AutoNexTeam/AUTONEX_BOT_2025/Team_Photo/Team Autonex.png

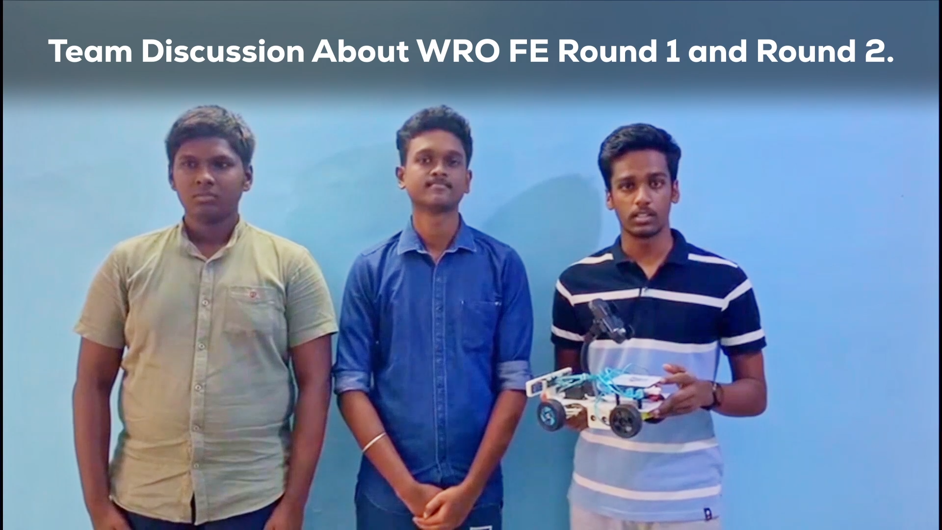
Team_Photo/Team Autonex.png
