AutoNexTeam/AUTONEX_BOT_2025/Bot Firmware/WRO_Round_1_Code_Final/WRO_Round_1_Code_Final.ino

// ########### Loop ############################################################################################################ //
int line_chk_count = 12;  // 3 Laps - 12 count, 1 Lap - 4 count.
int line_count = 0; // 12
//#---Bot Speeds---######################################################################
int normal_speed = 200;//pwm
int turn_speed = 220;//pwm
int turn_delay = 2000;//ms
//#######################################################################################
int fus_slow_speed = 200;//pwm
int fus_slow_dist = 130;//cm
//#---Servo Angles---####################################################################
int servo_center = 100;//deg
int left_turn_angle = servo_center - 20; //80 deg
int right_turn_angle = servo_center + 20;//120 deg
//####################################################################
const int blue_line_thold = 8000; //Blue Color Temp value
const int orange_line_thold = 3000; //Orange Color Temp value
//####################################################################
bool COLOR_LOCK = 1;
bool lt_st_count = 0;
bool rt_st_count = 0;

bool left_right_arc_turn = 1;
bool left_right_r_turn = 0;
//#########################################################################################//
#define DPDT_Push_Button_Pin 34

int col_val, start_col, colour_line;  // colour_line = 1 ->> Orange // colour_line = 3 ->> Blue
int f_us, f1_us, f2_us, b_us, l_us, r_us, fusa, far;

bool LOGIC_LOCK = 1; //1 True state.
bool DPDT_STATE = 0; //0 False state.
//#########################################################################################//

void loop() {
  
  DPDT_STATE = digitalRead(DPDT_Push_Button_Pin);
  //Serial.println("DPDT Button State : "+String(DPDT_STATE));

  US_Values(f_us, f1_us, f2_us, b_us, l_us, r_us);
  // Serial.println("F_US : " + String(f_us) + " | F1_US : " + String(f1_us) + " | F2_US : " + String(f2_us) + 
  //             " | B_US : " + String(b_us) + 
  //             " | L_US : " + String(l_us) + " | R_US : " + String(r_us));

  col_val = front_colour_sensor();
  //Serial.println("Color Value : " + String(col_val));

  color_line_fun(); // color line pickup

  
  if (DPDT_STATE == 1) 
  { 
    if (LOGIC_LOCK == 1) 
    { 
      if (col_val != 0)
      {
        color_logic_fun();
      }
      else if (col_val == 0)
      {
        side_us_logic_fun();
      }   
    }     
  }
  else
  {
    bot_shutdown();
  }

  if (line_count == line_chk_count) 
  {
    end_stop();
    bot_shutdown();
    LOGIC_LOCK = 0;
    line_count = 0; 
  }   

}


void color_line_fun()
{
  if(COLOR_LOCK == 1)
  {
    if(col_val == 1)
    {
      start_col = 1;
      colour_line = 1;
      COLOR_LOCK = 0;
    }
    else if(col_val == 3)
    {
      start_col = 3;
      colour_line = 3;
      COLOR_LOCK = 0;
    }
  }
}

void color_logic_fun()
{

   //# Orange Line & Right Turn Condition: #/////////////////////////////////////////////////////////////////
      if ((col_val == colour_line) && (col_val != 3))
      { 
        line_count++;
        Serial.println("Orange Line Count : " + String(line_count));

        if(left_right_arc_turn)
        {
          rgb_led(0, 0, 0);  
          delay(1);
          motor_forward(turn_speed);
          rgb_led(150, 0, 150);
          moveServoTo(right_turn_angle);
          delay(turn_delay);
          moveServoTo(servo_center);
          delay(1);
          rgb_led(0, 0, 0);
        }

        if(left_right_r_turn)
        {
          rgb_led(0, 0, 0);
          motor_forward(turn_speed);
          delay(1); 
          rgb_led(150, 0, 150);

          moveServoTo(right_turn_angle);
          delay(1500); 
          motor_backward(210);
          delay(1);      
          moveServoTo(left_turn_angle);
          delay(1500);
          moveServoTo(servo_center);
          delay(1);  
          motor_forward(200);
          delay(1); 
          rgb_led(0, 0, 0);
        }

      } 
      
      //# Blue Line & Left Turn Condition: #/////////////////////////////////////////////////////////////////
      if ((col_val == colour_line) && (col_val != 1))
      { 
        line_count++;
        Serial.println("Blue Line Count : " + String(line_count));

        if(left_right_arc_turn)
        {
          rgb_led(0, 0, 0);
          delay(1);
          motor_forward(turn_speed);
          rgb_led(150, 0, 150);
          moveServoTo(left_turn_angle);
          delay(turn_delay);
          moveServoTo(servo_center);
          rgb_led(0, 0, 0);
        }
        
        if(left_right_r_turn)
        {
          rgb_led(0, 0, 0);
          motor_forward(turn_speed);
          delay(1); 
          rgb_led(150, 0, 150);

          moveServoTo(left_turn_angle);
          delay(1500); 
          motor_backward(turn_speed);
          delay(1);      
          moveServoTo(right_turn_angle);
          delay(1500);
          moveServoTo(servo_center);
          delay(1);  
          motor_forward(200);
          delay(1); 
          rgb_led(0, 0, 0);
        }
        

        
      } 

}

void side_us_logic_fun()
{              
    if(f_us < fus_slow_dist){motor_forward(fus_slow_speed);}
    else{motor_forward(normal_speed);}

    if ((l_us < 30) && (l_us != 0))
    { 
        rgb_led(0, 0, 0);
        rgb_led(255, 0, 50); 
        moveServoTo(servo_center + 10);

        if(rt_st_count == 0)
        {
          if(lt_st_count == 0)
          {
            lt_st_count = 1;
          }
        }

    }
    if ((l_us > 30) && (r_us > 30) && (l_us != 0) && (r_us != 0)) 
    { 
        rgb_led(0, 0, 0);
        rgb_led(255, 255, 0);
        moveServoTo(servo_center); //100
    } 

    if ((r_us < 30) && (r_us != 0))
    {
        rgb_led(0, 0, 0);
        rgb_led(255, 0, 50); 
        moveServoTo(servo_center - 10);//90

        if(lt_st_count == 0)
        {
          if(rt_st_count == 0)
          {
            rt_st_count = 1;
          }
        }

    }
}

void bot_shutdown()
{
  motor_stop();
  moveServoTo(servo_center);
  rgb_led(0, 0, 0);
}

void left_stop()
{
  rgb_led(0, 0, 0);
  delay(1);
  rgb_led(255, 255, 255);
  
  if(left_right_arc_turn)
  {
    motor_forward(210);
    delay(1000);
  }
  moveServoTo(left_turn_angle);
  delay(1500);
  moveServoTo(right_turn_angle);
  delay(1500);
  moveServoTo(servo_center);
  delay(1000);
  
  rgb_led(0, 0, 0);
}

void right_stop()
{
  rgb_led(0, 0, 0);
  delay(1);
  rgb_led(255, 255, 255);

  if(left_right_arc_turn)
  {
    motor_forward(210);
    delay(1000);
  }
  moveServoTo(right_turn_angle);
  delay(1500);
  moveServoTo(left_turn_angle);
  delay(1500);
  moveServoTo(servo_center);
  delay(1000);

  rgb_led(0, 0, 0);

}

void end_stop()
{

  if(start_col == 3)
  {
      // Anti-clock wise:
      if(colour_line == 3)
      {
        if(lt_st_count == 1)
        {
          left_stop();
        }
        else if(rt_st_count == 1)
        {
          right_stop();
        }
      }

      if(colour_line == 1)
      {
        if(lt_st_count == 1)
        {
          right_stop();
        }
        else if(rt_st_count == 1)
        {
          left_stop();
        }
      }
  }
  
 ///////////////////////////////////////////////////////////////////
  if(start_col == 1)
  {
      // clock wise:
      if(colour_line == 3)
      {
        if(lt_st_count == 1)
        {
          right_stop();
        }
        else if(rt_st_count == 1)
        {
          left_stop();
        }
      }

      if(colour_line == 1)
      {
        if(lt_st_count == 1)
        {
          left_stop();
        }
        else if(rt_st_count == 1)
        {
          right_stop();
        }
      }
  }

}
